ihn-int/SeniorProject/Software/uartboot/uartboot.c

// =============================================================================
//  Program : uartboot.c
//  Author  : Chun-Jen Tsai
//  Date    : Nov/12/2021
// -----------------------------------------------------------------------------
//  Description:
//  This is the boot code for Aquila SoC.  Upon reset, the boot code waiting
//  for an ELF program file to be transferred from the UART port.
//  The processor will be halted when the execution is finished.
// -----------------------------------------------------------------------------
//  Revision information:
//
//  Sep/17/2022, by Chun-Jen Tsai
//    Modify the ELF loader to perform on-the-fly loading from UART without
//    using any ELF file loading buffer.
//
//  Oct/15/2022, by Chun-Jen Tsai
//    Use different schemes for loading into TCM (on-the-fly) and into
//    DRAM (buffered loasding).
//
//  Jan/24/2025, by Jun-Kai Chen
//    Modify the pseudo instruction of addressing variable to fit the medany
//    memory model. Also modify the size of header buffers to fit the elf64
//    format.
// -----------------------------------------------------------------------------
//  License information:
//
//  This software is released under the BSD-3-Clause Licence,
//  see https://opensource.org/licenses/BSD-3-Clause for details.
//  In the following license statements, "software" refers to the
//  "source code" of the complete hardware/software system.
//
//  Copyright 2019,
//                    Embedded Intelligent Systems Lab (EISL)
//                    Deparment of Computer Science
//                    National Yang Ming Chiao Tung Uniersity (NYCU)
//                    Hsinchu, Taiwan.
//
//  All rights reserved.
//
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
//  3. Neither the name of the copyright holder nor the names of its contributors
//     may be used to endorse or promote products derived from this software
//     without specific prior written permission.
//
//  THIS SOFTWARE IS PROVIDED BY THE COPYRIGHT HOLDERS AND CONTRIBUTORS "AS IS"
//  AND ANY EXPRESS OR IMPLIED WARRANTIES, INCLUDING, BUT NOT LIMITED TO, THE
//  IMPLIED WARRANTIES OF MERCHANTABILITY AND FITNESS FOR A PARTICULAR PURPOSE
//  ARE DISCLAIMED. IN NO EVENT SHALL THE COPYRIGHT HOLDER OR CONTRIBUTORS BE
//  LIABLE FOR ANY DIRECT, INDIRECT, INCIDENTAL, SPECIAL, EXEMPLARY, OR
//  CONSEQUENTIAL DAMAGES (INCLUDING, BUT NOT LIMITED TO, PROCUREMENT OF
//  SUBSTITUTE GOODS OR SERVICES; LOSS OF USE, DATA, OR PROFITS; OR BUSINESS
//  INTERRUPTION) HOWEVER CAUSED AND ON ANY THEORY OF LIABILITY, WHETHER IN
//  CONTRACT, STRICT LIABILITY, OR TORT (INCLUDING NEGLIGENCE OR OTHERWISE)
//  ARISING IN ANY WAY OUT OF THE USE OF THIS SOFTWARE, EVEN IF ADVISED OF THE
//  POSSIBILITY OF SUCH DAMAGE.
// =============================================================================
#include <elf.h>
#include <stdint.h>
#include "io_uart.h"

int load_elf(Elf64_Ehdr *ehdr);
void dram_test();

// ------------------------------------------------------------------------------
//  Memory Map:
//     0x00000000 ~ 0x0000FFFF: on-chip memory (64KB, boot code)
//     0x80000000 ~ 0x8FFFFFFF: main memory (code, data, heap, and stack)
//     0xC0000000 ~ 0xCFFFFFFF: I/O device area
//     0xF0000000 ~ 0xFFFFFFFF: system device area
// ------------------------------------------------------------------------------

uint8_t *prog;
uint8_t eheader[64], pheader[56*4];
char    *organization = "EISL@NYCU, Hsinchu, Taiwan";
int     year = 2024;

int main(void)
{
    Elf64_Ehdr *ehdr = (Elf64_Ehdr *) eheader;
    uint32_t *magic = (uint32_t *) ELFMAG;
    uint32_t size;
    int idx;

    printf("=======================================================================\n");
    printf("Copyright (c) 2019-%d, %s.\n", year, organization);
    
    printf("The Aquila SoC is ready.\n");
    printf("Waiting for an ELF file to be sent from the UART ...\n");
    
    
    // Read the ELF header.
    for (idx = 0; idx < sizeof(Elf64_Ehdr); idx++)
    {
        eheader[idx] = inbyte();
    }

    // Read the Program headers.
    for (idx = 0; idx < ehdr->e_phentsize*ehdr->e_phnum; idx++)
    {
        pheader[idx] = inbyte();
    }
    if (*((uint32_t *) ehdr->e_ident) == *magic)
    {
        prog = (uint8_t *) ehdr->e_entry; // set program entry point
        size = ehdr->e_shoff + (ehdr->e_shentsize * ehdr->e_shnum);
        
        load_elf(ehdr);
        
        printf("\nProgram entry point at 0x%x, size = 0x%x.\n", prog, size);
        printf("-----------------------------------------------------------------------\n");
        
        // Call the entry point for execution.
        asm volatile ("fence.i");
        asm volatile ("la t0, prog");
        asm volatile ("ld ra, 0(t0)");
        asm volatile ("jalr ra, ra, 0");
        
    }
    else
    {
        printf("\n\nMagic number = 0x%X\n", *((uint32_t *) ehdr->e_ident));
        printf("\nThe magic number should be 0x%X\n", *magic);
        printf("Error! Not an ELF file.\n\n");
    }
    // Halt the processor.
    
    exit(0);
    
    return 0;
}

int load_elf(Elf64_Ehdr *ehdr)
{
    Elf64_Phdr *section;
    uint32_t skip, current_byte;
    uint32_t *mem;
    uint8_t  *dst_addr;
    int idx, jdx;

    current_byte = sizeof(Elf64_Ehdr) + ehdr->e_phentsize*ehdr->e_phnum;

    // Load all loadable sections of an ELF image to the destination.
    section = (Elf64_Phdr *) pheader;
    for (idx = 0; idx < ehdr->e_phnum; idx++)
    {    
        if (section[idx].p_type == PT_LOAD && section[idx].p_filesz != 0)
        {
            
            
            dst_addr = (uint8_t *) section[idx].p_paddr;
            skip = section[idx].p_offset - current_byte;
            while (skip-- > 0) inbyte(), current_byte++;

            for (jdx = 0; jdx < section[idx].p_filesz; jdx++)
            {
                dst_addr[jdx] = inbyte();
                current_byte++;
            }
            mem = (uint32_t *) &(dst_addr[jdx]);
            while (jdx < section[idx].p_memsz)
            {
                mem[(jdx>>2)] = 0;
                jdx += sizeof(int);
            }
            
        }
        
    }
    return 0;
}
