ihn-int/SeniorProject/Hardware/dram_version/src/core_rtl/dcache.v

`timescale 1ns / 1ps
// =============================================================================
//  Program : dcache.v
//  Author  : Jin-you Wu
//  Date    : Nov/01/2018
// -----------------------------------------------------------------------------
//  Description:
//  This module implements the L1 Data Cache with the following
//  properties:
//      4-way set associative
//      FIFO replacement policy
//      Write-back
//      Write allocate
// -----------------------------------------------------------------------------
//  Revision information:
//
//  Mar/03/2020, by Chih-Yu Hsiang:
//    Added AMO support.
//
//  Sep/24/2023, by Chun-Jen Tsai:
//    Modify the code to use distributed RAM to store VALID and DIRTY bits.
//    This modification significantly reduces the resource usage.
//
//  Jun/17/2025, by Jun-Kai Chen:
//    Modify data rearrangement to fit 64-bit bus.
// -----------------------------------------------------------------------------
//  License information:
//
//  This software is released under the BSD-3-Clause Licence,
//  see https://opensource.org/licenses/BSD-3-Clause for details.
//  In the following license statements, "software" refers to the
//  "source code" of the complete hardware/software system.
//
//  Copyright 2019,
//                    Embedded Intelligent Systems Lab (EISL)
//                    Deparment of Computer Science
//                    National Chiao Tung Uniersity
//                    Hsinchu, Taiwan.
//
//  All rights reserved.
//
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
//  3. Neither the name of the copyright holder nor the names of its contributors
//     may be used to endorse or promote products derived from this software
//     without specific prior written permission.
//
//  THIS SOFTWARE IS PROVIDED BY THE COPYRIGHT HOLDERS AND CONTRIBUTORS "AS IS"
//  AND ANY EXPRESS OR IMPLIED WARRANTIES, INCLUDING, BUT NOT LIMITED TO, THE
//  IMPLIED WARRANTIES OF MERCHANTABILITY AND FITNESS FOR A PARTICULAR PURPOSE
//  ARE DISCLAIMED. IN NO EVENT SHALL THE COPYRIGHT HOLDER OR CONTRIBUTORS BE
//  LIABLE FOR ANY DIRECT, INDIRECT, INCIDENTAL, SPECIAL, EXEMPLARY, OR
//  CONSEQUENTIAL DAMAGES (INCLUDING, BUT NOT LIMITED TO, PROCUREMENT OF
//  SUBSTITUTE GOODS OR SERVICES; LOSS OF USE, DATA, OR PROFITS; OR BUSINESS
//  INTERRUPTION) HOWEVER CAUSED AND ON ANY THEORY OF LIABILITY, WHETHER IN
//  CONTRACT, STRICT LIABILITY, OR TORT (INCLUDING NEGLIGENCE OR OTHERWISE)
//  ARISING IN ANY WAY OUT OF THE USE OF THIS SOFTWARE, EVEN IF ADVISED OF THE
//  POSSIBILITY OF SUCH DAMAGE.
// =============================================================================
`include "aquila_config.vh"

module dcache
#(parameter XLEN = 64,
  parameter CACHE_SIZE = 4, // KB
  parameter CLSIZE = `CLP    // Cache line size.
)
(
    /////////// System signals   ///////////////////////////////////////////////
    input                     clk_i, rst_i,

    /////////// Processor signals //////////////////////////////////////////////
    input                     p_strobe_i,      // Processor request signal.
    input                     p_rw_i,          // 0 for read, 1 for write.
    input  [XLEN/8-1 : 0]     p_byte_enable_i, // Byte-enable signal.
    input  [XLEN-1 : 0]       p_addr_i,        // Memory addr of the request.
    input  [XLEN-1 : 0]       p_data_i,        // Data to main memory.
    output reg [XLEN-1 : 0]   p_data_o,        // Data from main memory.
    output                    p_ready_o,       // The cache data is ready.
    input                     p_flush_i,       // Cache flush request.

    /////////// External memory signals   //////////////////////////////////////
    output reg                m_strobe_o,      // Cache request to memory.
    output reg [XLEN-1 : 0]   m_addr_o,        // Address of the request.
    output reg                m_rw_o,          // 0 for read, 1 for write.
    input  [CLSIZE-1 : 0]     m_data_i,        // Data from memory controller.
    output reg [CLSIZE-1 : 0] m_data_o,        // Cache data to memory controller.
    input                     m_ready_i,       // Data from memory is ready.

    /////////// Control signals to other caches   //////////////////////////////
    output reg                busy_flushing_o, // D-Cache is busy flushing

    /////////// AMO signals      ///////////////////////////////////////////////
    input                     p_is_amo_i,      // AMO request from core.
    input  [4 : 0]            p_amo_type_i,    // Type of AMO from core.
    input                     p_amo_word_sel_i,// Word select from core. New signal
    output                    m_is_amo_o,      // AMO request to D-memory.
    output reg [4 : 0]        m_amo_type_o,    // Type of AMO to D-memory.
    output reg                m_amo_word_sel_o // Word select from core. New signal
);

//=======================================================
// Cache parameters
//=======================================================
localparam N_WAYS      = 4;
localparam N_LINES     = (CACHE_SIZE*1024*8) / (N_WAYS*CLSIZE); // 64

localparam WAY_BITS    = $clog2(N_WAYS);
localparam BYTE_BITS   = $clog2(XLEN/8); // A dword is 8 bytes
localparam WORD_BITS   = $clog2(CLSIZE/XLEN); // A dword is 64 bits
localparam LINE_BITS   = $clog2(N_LINES);
localparam NONTAG_BITS = LINE_BITS + WORD_BITS + BYTE_BITS;
localparam TAG_BITS    = XLEN - NONTAG_BITS;

//=======================================================
// N-way associative cache signals
//=======================================================
wire                   way_hit[0 : N_WAYS-1];     // Cache-way hit flag.
reg  [WAY_BITS-1 : 0]  hit_index;                 // Decoded way_hit[] signal.
wire                   cache_hit;                 // Got a cache hit?
reg  [CLSIZE-1 : 0]    c_data_i;                  // Data to write into cache.
reg  [CLSIZE-1 : 0]    c_data_update;             // Updated cache data.
reg  [CLSIZE-1 : 0]    m_data_update;             // Updated memory data.
wire [CLSIZE-1 : 0]    c_block[0 : N_WAYS-1];     // Cache blocks from N cache way.
wire [CLSIZE-1 : 0]    c_data_hit;                // Data from the hit cache block.
reg                    cache_write[0 : N_WAYS-1]; // WE signal for a $ tag & block.
reg                    valid_write[0 : N_WAYS-1]; // WE signal for a $ valid bit.
reg                    dirty_write[0 : N_WAYS-1]; // WE signal for a $ dirty bit.
wire [TAG_BITS-1 : 0]  c_tag_o[0 : N_WAYS-1];     // Tag bits of current $ blocks.
wire                   c_valid_o[0 : N_WAYS-1];   // Validity of current $ blocks.
wire                   c_dirty_o[0 : N_WAYS-1];   // Dirtiness of current $ blocks.
reg  [LINE_BITS-1 : 0] init_count;                // Counter to initialize valid bits.

integer idx;

assign c_data_hit = c_block[hit_index];

//=======================================================
// FIFO replacement policy signals
//=======================================================
reg  [WAY_BITS-1 : 0] FIFO_cnt[0 : N_LINES-1];   // Replace policy counter.
reg  [WAY_BITS-1 : 0] victim_sel;                // The victim cache select.

//=======================================================
// Cache line and tag calculations
//=======================================================
wire [WORD_BITS-1 : 0] line_offset;
wire [LINE_BITS-1 : 0] line_index;
wire [TAG_BITS-1  : 0] tag;
wire [LINE_BITS-1 : 0] addr_sram;
reg  [XLEN-1 : 0]      p_addr_r;

assign line_offset = (p_strobe_i)? p_addr_i[WORD_BITS + BYTE_BITS - 1 : BYTE_BITS] :
                                   p_addr_r[WORD_BITS + BYTE_BITS - 1 : BYTE_BITS];
assign line_index  = (p_strobe_i)? p_addr_i[NONTAG_BITS - 1 : WORD_BITS + BYTE_BITS] :
                                   p_addr_r[NONTAG_BITS - 1 : WORD_BITS + BYTE_BITS];
assign tag         = p_addr_r[XLEN - 1 : NONTAG_BITS];

//=======================================================
// Processor and memory interface signals
//=======================================================

// Input signal from processor   //////////////////////////////////////////
reg [XLEN-1 : 0] datain_from_p;
reg              rw;                 // 0 is for read, 1 is for write
reg [XLEN/8-1:0] byte_enable_from_p; // Which bytes are written if (rw == 1)
reg              is_amo_reg;

// Output signal to processor
reg              p_ready_reg;

// Input data from memory /////////////////////////////////////////////////
reg [CLSIZE-1 : 0] m_data;

//=======================================================
// Control signals for flushing all cache blocks
//=======================================================
reg [LINE_BITS-1 : 0] N_LINES_cnt;
reg [WAY_BITS-1 : 0]  N_WAYS_cnt;
wire NeedtoWb = c_dirty_o[N_WAYS_cnt];
wire WbAllFinish = (N_LINES_cnt == N_LINES - 1 && N_WAYS_cnt == N_WAYS - 1);
reg WbAllFinish_r;

//=======================================================
// Cache Finite State Machine
//=======================================================
localparam Init             = 0,
           Idle             = 1,
           Analysis         = 2,
           WbtoMem          = 3,
           WbtoMemFinish    = 4,
           RdfromMem        = 5,
           RdfromMemFinish  = 6,
           WbtoMemAll       = 7,
           WbtoMemAllFinish = 8,
           RdAmo            = 9,
           RdAmoFinish      = 10;

// Cache controller state registers
reg [ 3 : 0] S, S_nxt;

//====================================================
// Cache Controller FSM
//====================================================
always @(posedge clk_i)
begin
    if (rst_i)
        S <= Init;
    else
        S <= S_nxt;
end

always @(*)
begin
    case (S)
        Init: // Multi-cycle initialization of the VALID bits memory.
            if (init_count < N_LINES - 1)
                S_nxt = Init;
            else
                S_nxt = Idle;
        Idle:
            if (p_strobe_i || p_flush_i)
                S_nxt = Analysis;
            else
                S_nxt = Idle;
        Analysis:
            if (busy_flushing_o)
                S_nxt = WbtoMemAll;
            else if (p_is_amo_i)
                S_nxt = (cache_hit & c_dirty_o[hit_index])? WbtoMem : RdAmo;
            else if (!cache_hit)
                S_nxt = (c_dirty_o[victim_sel])? WbtoMem : RdfromMem;
            else // cache hit and not amo
                S_nxt = Idle;
        WbtoMem:
            if (m_ready_i)
                S_nxt = WbtoMemFinish;
            else
                S_nxt = WbtoMem;
        WbtoMemFinish:
            S_nxt = (p_is_amo_i)? RdAmo : RdfromMem;
        RdfromMem:
            if (m_ready_i)
                S_nxt = RdfromMemFinish;
            else
                S_nxt = RdfromMem;
        RdfromMemFinish:
            S_nxt = Idle;
        WbtoMemAll:
            if (NeedtoWb)
                if (m_ready_i)
                    S_nxt = WbtoMemAllFinish;
                else
                    S_nxt = WbtoMemAll;
            else
                S_nxt = WbtoMemAllFinish;
        WbtoMemAllFinish:
            S_nxt = (WbAllFinish_r)? Idle : WbtoMemAll;
        RdAmo:
            if (m_ready_i)
                S_nxt = RdAmoFinish;
            else
                S_nxt = RdAmo;
        RdAmoFinish:
            S_nxt = Idle;
        default:
            S_nxt = Idle;
    endcase
end

// Initialization of the valid bits to zeros upon reset.
always @ (posedge clk_i)
begin
    if (S == Init)
        init_count <= init_count + 1;
    else
        init_count <= {LINE_BITS{1'b0}};
end

// Check and see if any cache way has the matched memory block.
assign way_hit[0] = (c_valid_o[0] && (c_tag_o[0] == tag))? 1 : 0;
assign way_hit[1] = (c_valid_o[1] && (c_tag_o[1] == tag))? 1 : 0;
assign way_hit[2] = (c_valid_o[2] && (c_tag_o[2] == tag))? 1 : 0;
assign way_hit[3] = (c_valid_o[3] && (c_tag_o[3] == tag))? 1 : 0;
assign cache_hit  = (way_hit[0] || way_hit[1] || way_hit[2] || way_hit[3]);

always @(*)
begin
    case ( { way_hit[0], way_hit[1], way_hit[2], way_hit[3] } )
        4'b1000: hit_index = 0;
        4'b0100: hit_index = 1;
        4'b0010: hit_index = 2;
        4'b0001: hit_index = 3;
        default: hit_index = 0; // error: multiple-way hit!
    endcase
end

always @(posedge clk_i)
begin
    victim_sel <= FIFO_cnt[line_index];
end

always @(posedge clk_i)
begin
    if (rst_i)
        for (idx = 0; idx < N_LINES; idx = idx + 1) FIFO_cnt[idx] <= 0;
    else if (S == RdfromMemFinish)
        FIFO_cnt[line_index] <= FIFO_cnt[line_index] + 1;
end

//====================================================
// Register some signals from the processor/memory.
//====================================================

// Register the address from the processor.
always@(posedge clk_i) begin
    if (rst_i) begin
        p_addr_r <= {XLEN{1'b0}};
    end else if (p_strobe_i) begin
        p_addr_r <= p_addr_i;
    end
end

// Register the data, rw, and byte enable signals from the processor.
always @(posedge clk_i)
begin
    if (S == Idle)
    begin
        datain_from_p <= p_data_i;
        rw <= p_rw_i;
        byte_enable_from_p <= p_byte_enable_i;
    end
    else
    begin
        datain_from_p <= datain_from_p;
        rw <= rw;
        byte_enable_from_p <= byte_enable_from_p;
    end
end

// Register the input data from the main memory.
always @(posedge clk_i)
begin
    if (S == RdfromMem || S == RdAmo)
        m_data <= m_data_i;
    else
        m_data <= m_data;
end

//=======================================================
// Write back all cache blocks to the main memory
//=======================================================
assign addr_sram   = (busy_flushing_o)? N_LINES_cnt : line_index;

always @(posedge clk_i)
begin
    if (rst_i || S == Idle)
        N_LINES_cnt <= {LINE_BITS{1'b0}};
    else if (S_nxt == WbtoMemAllFinish)
        N_LINES_cnt <= N_LINES_cnt + 1;
end

always @(posedge clk_i)
begin
    if (rst_i || S == Idle)
        N_WAYS_cnt <= {WAY_BITS{1'b0}};
    else if (N_LINES_cnt == N_LINES - 1 && S_nxt == WbtoMemAllFinish)
        N_WAYS_cnt <= N_WAYS_cnt + 1;
end

always @(posedge clk_i) begin
    WbAllFinish_r <= WbAllFinish;
end

//-----------------------------------------------
// Read a 32-bit word from the target cache line
//-----------------------------------------------
reg [XLEN-1 : 0] fromCache; // Get the specific word in cache line
reg [XLEN-1 : 0] fromMem;   // Get the specific word in memory line

always @(*)
begin // for hit
    case (line_offset)
`ifdef ARTY
        1'b0: fromCache = c_data_hit[127: 64];
        1'b1: fromCache = c_data_hit[ 63:  0];
`else // KC705, hasn't finished yet.
        3'b111: fromCache = c_data_hit[ 31: 0];    // [255:224]
        3'b110: fromCache = c_data_hit[ 63: 32];   // [223:192]
        3'b101: fromCache = c_data_hit[ 95: 64];   // [191:160]
        3'b100: fromCache = c_data_hit[127: 96];   // [159:128]
        3'b011: fromCache = c_data_hit[159: 128];  // [127: 96]
        3'b010: fromCache = c_data_hit[191: 160];  // [ 95: 64]
        3'b001: fromCache = c_data_hit[223: 192];  // [ 63: 32]
        3'b000: fromCache = c_data_hit[255: 224];  // [ 31:  0]
`endif
    endcase
end

always @(*)
begin // for miss
    case (line_offset)
`ifdef ARTY
        1'b0: fromMem = m_data[127: 64];
        1'b1: fromMem = m_data[ 63:  0];
`else // KC705, hasn't finished yet.
        3'b111: fromMem = m_data[ 31: 0];       // [255:224]
        3'b110: fromMem = m_data[ 63: 32];      // [223:192]
        3'b101: fromMem = m_data[ 95: 64];      // [191:160]
        3'b100: fromMem = m_data[127: 96];      // [159:128]
        3'b011: fromMem = m_data[159: 128];     // [127: 96]
        3'b010: fromMem = m_data[191: 160];     // [ 95: 64]
        3'b001: fromMem = m_data[223: 192];     // [ 63: 32]
        3'b000: fromMem = m_data[255: 224];     // [ 31:  0]
`endif
    endcase
end

//======================================================================
// Generate Output signals.
//======================================================================

always @(*)
begin // Note: p_data_o is significant when processor read data
    if (S == RdAmoFinish)
        p_data_o = m_data[CLSIZE-1:CLSIZE-XLEN];
    else if ((S == Analysis) && cache_hit && !rw)
        p_data_o = fromCache;
    else if ((S == RdfromMemFinish) && !rw)
        p_data_o = fromMem;
    else
        p_data_o = {XLEN{1'b0}};
end

always @(*)
begin
    if (((S == Analysis) && cache_hit && ~p_is_amo_i && !p_flush_i) ||
        (S == RdfromMemFinish) ||
        (S == RdAmoFinish) ||
        (S == WbtoMemAllFinish && WbAllFinish_r))
        p_ready_reg = 1;
    else
        p_ready_reg = 0;
end

assign p_ready_o = p_ready_reg;

//======================================================================
// Create a single-cycle memory request pluse for the memory controller
//======================================================================
// The old code uses the reqest/act protocol, which is corrected by the
// CDC synchronizer to match the strobe protocol of MIG. Modified to
// strobe protocol by Chun-Jen Tsai, 09/29/2023.
wire m_strobe;
reg  m_strobe_r;

assign m_strobe = (S == RdfromMem || S == WbtoMem || S == RdAmo ||
                  (S == WbtoMemAll && NeedtoWb)) && !m_ready_i;

always @(posedge clk_i)
    m_strobe_r <= m_strobe;

always @(posedge clk_i)
begin
    if (rst_i)
        m_strobe_o <= 0;
    else if (m_strobe && !m_strobe_r)
        m_strobe_o <= 1;
    else
        m_strobe_o <= 0;
end
//======================================================================

// Modified: Use the byte bits to present the address.
always @(posedge clk_i)
begin
    if (rst_i)
        m_addr_o <= 0;
    else if (S == WbtoMemAll)
        m_addr_o <= {c_tag_o[N_WAYS_cnt], N_LINES_cnt, {WORD_BITS{1'b0}}, {BYTE_BITS{1'b0}}};
    else if (S == WbtoMem) // the dirty data addr
        m_addr_o <= (is_amo_reg)?
                        {c_tag_o[hit_index], line_index, {WORD_BITS{1'b0}}, {BYTE_BITS{1'b0}}} :
                        {c_tag_o[victim_sel], line_index, {WORD_BITS{1'b0}}, {BYTE_BITS{1'b0}}};
    else if (S == RdfromMem) // read a cache block
        m_addr_o <= {p_addr_i[XLEN-1 : WORD_BITS+BYTE_BITS], {WORD_BITS{1'b0}}, {BYTE_BITS{1'b0}}};
    else if (S == RdAmo)
        m_addr_o <= p_addr_i;
    else
        m_addr_o <= {XLEN{1'b0}};
end

always @(posedge clk_i)
begin
    if (rst_i)
        m_data_o <= 0;
    else if (S == WbtoMemAll && NeedtoWb)
        m_data_o <= c_block[N_WAYS_cnt];
    else if (S == WbtoMem) // the dirty data write back to memory
        m_data_o <= (is_amo_reg)? c_data_hit : c_block[victim_sel];
    else if (S == RdAmo)
        m_data_o <= {p_data_i, {CLSIZE-XLEN{1'b0}}};
    else
        m_data_o <= 0;
end

//------------------------------------------------------------------------
// Write the correct bytes according to the signal byte_enable_from_p
//------------------------------------------------------------------------
reg [XLEN-1 : 0] update_data;

always @(*)
begin           // write miss : write hit;
    case (byte_enable_from_p)
        // DataMem_Addr[2:0] == 3'b000
        8'b0000_0001: // store byte
            update_data = (S == RdfromMemFinish) ?
                {   fromMem[63:8], datain_from_p[7:0] } :
                { fromCache[63:8], datain_from_p[7:0] };
        8'b0000_0011: // store half
            update_data = (S == RdfromMemFinish) ?
                {   fromMem[63:16], datain_from_p[15:0] } :
                { fromCache[63:16], datain_from_p[15:0] };
        8'b0000_1111: // store word
            update_data = (S == RdfromMemFinish) ?
                {   fromMem[63:32], datain_from_p[31:0] } :
                { fromCache[63:32], datain_from_p[31:0] };
        8'b1111_1111: // store dword
            update_data = datain_from_p;
        // DataMem_Addr[2:0] == 3'b001
        8'b0000_0010: // store byte
            update_data = (S == RdfromMemFinish) ?
                {   fromMem[63:16], datain_from_p[15:8],   fromMem[7:0] } :
                { fromCache[63:16], datain_from_p[15:8], fromCache[7:0] };
        // DataMemAddr[2:0] == 3'b010
        8'b0000_0100: // store byte
            update_data = (S == RdfromMemFinish) ?
                {   fromMem[63:24], datain_from_p[23:16],   fromMem[15:0] } :
                { fromCache[63:24], datain_from_p[23:16], fromCache[15:0] };
        8'b0000_1100: // store half
            update_data = (S == RdfromMemFinish) ?
                {   fromMem[63:32], datain_from_p[31:16],   fromMem[15:0] } :
                { fromCache[63:32], datain_from_p[31:16], fromCache[15:0] };
        // DataMem_Addr[2:0] == 3'b011
        8'b0000_1000: // store byte
            update_data = (S == RdfromMemFinish) ?
                {   fromMem[63:32], datain_from_p[31:24],   fromMem[23:0] } :
                { fromCache[63:32], datain_from_p[31:24], fromCache[23:0] };
        // DataMem_Addr[2:0] == 3'b100
        8'b0001_0000: // store byte
            update_data = (S == RdfromMemFinish) ?
                {   fromMem[63:40], datain_from_p[39:32],   fromMem[31:0] } :
                { fromCache[63:40], datain_from_p[39:32], fromCache[31:0] };
        8'b0011_0000: // store half
            update_data = (S == RdfromMemFinish) ?
                {   fromMem[63:48], datain_from_p[47:32],   fromMem[31:0] } :
                { fromCache[63:48], datain_from_p[47:32], fromCache[31:0] };
        8'b1111_0000: // store word
            update_data = (S == RdfromMemFinish) ?
                { datain_from_p[63:32],   fromMem[31:0] } :
                { datain_from_p[63:32], fromCache[31:0] };
        // DataMem_Addr[2:0] == 3'b101
        8'b0010_0000: // store byte
            update_data = (S == RdfromMemFinish) ?
                {   fromMem[63:48], datain_from_p[47:40],   fromMem[39:0] } :
                { fromCache[63:48], datain_from_p[47:40], fromCache[39:0] };
        // DataMem_Addr[2:0] == 3'b110
        8'b0100_0000: // store byte
            update_data = (S == RdfromMemFinish) ?
                {   fromMem[63:56], datain_from_p[55:48],   fromMem[47:0] } :
                { fromCache[63:56], datain_from_p[55:48], fromCache[47:0] };
        8'b1100_0000: // store half
            update_data = (S == RdfromMemFinish) ?
                { datain_from_p[63:48],   fromMem[47:0] } :
                { datain_from_p[63:48], fromCache[47:0] };
        // DataMem_Addr[2:0] == 3'b111
        8'b1000_0000: // store byte
            update_data = (S == RdfromMemFinish) ?
                { datain_from_p[63:56],   fromMem[55:0] } :
                { datain_from_p[63:56], fromCache[55:0] };
        default: update_data = 64'b0;
    endcase
end

//------------------------------------------------------------------------
// Write a 64-bit dword into the target cache line.
//------------------------------------------------------------------------
/* Writing into cache from the processor or the main memory */
always @(*) begin
    case (line_offset)
`ifdef ARTY
        1'b0: c_data_update = {update_data, c_data_hit[63: 0]};
        1'b1: c_data_update = {c_data_hit[127: 64], update_data};
`else // KC705, hasn't finished yet.
        3'b111: c_data_update = {c_data_hit[255: 32], update_data};
        3'b110: c_data_update = {c_data_hit[255: 64], update_data, c_data_hit[ 31:0]};
        3'b101: c_data_update = {c_data_hit[255: 96], update_data, c_data_hit[ 63:0]};
        3'b100: c_data_update = {c_data_hit[255:128], update_data, c_data_hit[ 95:0]};
        3'b011: c_data_update = {c_data_hit[255:160], update_data, c_data_hit[127:0]};
        3'b010: c_data_update = {c_data_hit[255:192], update_data, c_data_hit[159:0]};
        3'b001: c_data_update = {c_data_hit[255:224], update_data, c_data_hit[191:0]};
        3'b000: c_data_update = {update_data, c_data_hit[223:0]};
`endif
    endcase
end

always @(*) begin
    case (line_offset)
`ifdef ARTY
        1'b0: m_data_update = {update_data, m_data[63: 0]};
        1'b1: m_data_update = {m_data[127: 64], update_data};
`else // KC705, hasn't finished yet.
        3'b111: m_data_update = {m_data[255: 32], update_data};
        3'b110: m_data_update = {m_data[255: 64], update_data, m_data[ 31:0]};
        3'b101: m_data_update = {m_data[255: 96], update_data, m_data[ 63:0]};
        3'b100: m_data_update = {m_data[255:128], update_data, m_data[ 95:0]};
        3'b011: m_data_update = {m_data[255:160], update_data, m_data[127:0]};
        3'b010: m_data_update = {m_data[255:192], update_data, m_data[159:0]};
        3'b001: m_data_update = {m_data[255:224], update_data, m_data[191:0]};
        3'b000: m_data_update = {update_data, m_data[223:0]};
`endif
    endcase
end

always @(*)
begin
    if (!rw) // Processor read miss and update cache data
        c_data_i = (S == RdfromMemFinish) ? m_data : {CLSIZE{1'b0}};
    else begin   // Processor write cache
        if ( (S == Analysis) && cache_hit ) // write hit
            c_data_i = c_data_update;
        else if (S == RdfromMemFinish)      // write miss
            c_data_i = m_data_update;
        else
            c_data_i = {CLSIZE{1'b0}};
    end
end

always @(posedge clk_i)
begin
    if (rst_i)
        m_rw_o <= 0;
    else if (S == WbtoMem || S == WbtoMemAll || S == RdAmo)
        m_rw_o <= 1;
    else
        m_rw_o <= 0; // default: Read memory
end

// AMO output signal
always @(posedge clk_i ) begin
    if (rst_i)
        is_amo_reg <= 1'b0;
    else if ( S == Analysis )
        is_amo_reg <= p_is_amo_i;
end

assign m_is_amo_o = (S == RdAmo) ? is_amo_reg : 1'b0 ;

always @(posedge clk_i ) begin
    // data signal don't reset
    if ( S == Analysis ) begin
        m_amo_type_o <= p_amo_type_i;
        m_amo_word_sel_o <= p_amo_word_sel_i;
    end    
end

// Set a signal for flushing-in-progress notification
always @(posedge clk_i) begin
    if (rst_i)
        busy_flushing_o <= 0;
    else if (S == Idle && !busy_flushing_o)
        busy_flushing_o <= p_flush_i;
    else if (WbAllFinish_r && S_nxt == WbtoMemAllFinish)
        busy_flushing_o <= 0;
end

//=======================================================================
//  Compute the write flags for cache block & tag, valid, and dirty bits
//=======================================================================
always @(*)
begin
    if ((S == Analysis) && cache_hit && rw)
        for (idx = 0; idx < N_WAYS; idx = idx + 1)
            cache_write[idx] = way_hit[idx];
    else if (S == RdfromMemFinish)
        for (idx = 0; idx < N_WAYS; idx = idx + 1)
            cache_write[idx] = (idx == victim_sel);
    else
        for (idx = 0; idx < N_WAYS; idx = idx + 1)
            cache_write[idx] = 1'b0;
end

always @(*)
begin
    if (S == Init)
        for (idx = 0; idx < N_WAYS; idx = idx + 1)
            valid_write[idx] = 1'b1;
    else if (S == RdfromMem && m_ready_i)
        for (idx = 0; idx < N_WAYS; idx = idx + 1)
            valid_write[idx] = (idx == victim_sel);
    else if (S == RdAmo && m_ready_i && cache_hit)
        for (idx = 0; idx < N_WAYS; idx = idx + 1)
            valid_write[idx] = (idx == hit_index);
    else
        for (idx = 0; idx < N_WAYS; idx = idx + 1)
            valid_write[idx] = 1'b0;
end

always @(*)
begin
    if (S == Init)
        for (idx = 0; idx < N_WAYS; idx = idx + 1)
            dirty_write[idx] = 1'b1;
    else if (S_nxt == WbtoMemAllFinish)
        for (idx = 0; idx < N_WAYS; idx = idx + 1)
            dirty_write[idx] = (idx == N_WAYS_cnt);
    else if (S == RdfromMem && m_ready_i && rw)
        for (idx = 0; idx < N_WAYS; idx = idx + 1)
            dirty_write[idx] = (idx == victim_sel);
    else if ((S == Analysis && cache_hit && rw) ||
             (S == RdAmo && m_ready_i && cache_hit))
        for (idx = 0; idx < N_WAYS; idx = idx + 1)
            dirty_write[idx] = (idx == hit_index);
    else
        for (idx = 0; idx < N_WAYS; idx = idx + 1)
            dirty_write[idx] = 1'b0;
end

//=======================================================
//  Cache data storage in Block RAM
//=======================================================
genvar i;
generate
    for (i = 0; i < N_WAYS; i = i + 1)
    begin
        sram #(.DATA_WIDTH(CLSIZE), .N_ENTRIES(N_LINES))
             DATA_BRAM(
                 .clk_i(clk_i),
                 .en_i(1'b1),
                 .we_i(cache_write[i]),
                 .addr_i(addr_sram),
                 .data_i(c_data_i),  // data from processor or memory.
                 .data_o(c_block[i])
             );
    end
endgenerate

//=======================================================
//  Tags storage in Block RAM
//=======================================================
genvar j;
generate
    for (j = 0; j < N_WAYS; j = j + 1)
    begin
        sram #(.DATA_WIDTH(TAG_BITS), .N_ENTRIES(N_LINES))
             TAG_BRAM(
                 .clk_i(clk_i),
                 .en_i(1'b1),
                 .we_i(cache_write[j]),
                 .addr_i(addr_sram),
                 .data_i(tag),
                 .data_o(c_tag_o[j])
             );
    end
endgenerate

//=======================================================
//  Valid bits storage in distributed RAM
//=======================================================
genvar k;
generate
    for (k = 0; k < N_WAYS; k = k + 1)
    begin
        distri_ram #(.ENTRY_NUM(N_LINES), .XLEN(1))
             VALID_RAM(
                 .clk_i(clk_i),
                 .we_i(valid_write[k]),
                 .read_addr_i(line_index),
                 .write_addr_i((S == Init)? init_count : line_index),
                 .data_i(S == RdfromMem && m_ready_i),
                 .data_o(c_valid_o[k])
             );
    end
endgenerate

//=======================================================
//  Dirty bits storage in distributed RAM
//=======================================================
wire [LINE_BITS-1 : 0] dirty_raddr = (S == WbtoMemAll)? N_LINES_cnt : line_index;
wire [LINE_BITS-1 : 0] dirty_waddr = (S_nxt == WbtoMemAllFinish)? N_LINES_cnt :
                                     (S == Init)? init_count : line_index;
wire                   dirty_datai = (S == RdfromMem && m_ready_i && rw) ||
                                     (S == Analysis && cache_hit && rw);
genvar m;
generate
    for (m = 0; m < N_WAYS; m = m + 1)
    begin
        distri_ram #(.ENTRY_NUM(N_LINES), .XLEN(1))
             DIRTY_RAM(
                 .clk_i(clk_i),
                 .we_i(dirty_write[m]),
                 .read_addr_i(dirty_raddr),
                 .write_addr_i(dirty_waddr),
                 .data_i(dirty_datai),
                 .data_o(c_dirty_o[m])
             );
    end
endgenerate

endmodule
