ihn-int/SeniorProject/Hardware/dram_version/src/core_rtl/csr_file.v

`timescale 1ns / 1ps
// =============================================================================
//  Program : csr_file.v
//  Author  : Jin-you Wu
//  Date    : Dec/18/2018
// -----------------------------------------------------------------------------
//  Description:
//  This module implements the Control and Status Register File of the
//  Aquila core (A RISC-V core).
// -----------------------------------------------------------------------------
//  Revision information:
//
//  Dec/16/2019, by Chun-Jen Tsai:
//    Map the CSR addresses of CYCLES & CYCLESH to that of MCYCLES & MCYCLESH's
//    counters so that 'RDCYCLE' & 'RDCYCLEH' pseudo instructions can read the
//    counters.
//
//  Aug/22/2020, by Yen-Yu Lee:
//    Major modification to CSR to support exception handling properly.
//    The original Aquila processes interrupts at the Execute stage and does
//    not handle exceptions. Now, both interrupts and exceptions generated at
//    various pipeline stages will be passed to and handled at the Writeback
//    stage.
//
//  Aug/26/2025, by Jun-Kai Chen:
//    Modify MXLEN, SXLEN, UXLEN to 64-bit and modify behavior per new SPEC.
// -----------------------------------------------------------------------------
//  License information:
//
//  This software is released under the BSD-3-Clause Licence,
//  see https://opensource.org/licenses/BSD-3-Clause for details.
//  In the following license statements, "software" refers to the
//  "source code" of the complete hardware/software system.
//
//  Copyright 2019,
//                    Embedded Intelligent Systems Lab (EISL)
//                    Deparment of Computer Science
//                    National Chiao Tung Uniersity
//                    Hsinchu, Taiwan.
//
//  All rights reserved.
//
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
//  3. Neither the name of the copyright holder nor the names of its contributors
//     may be used to endorse or promote products derived from this software
//     without specific prior written permission.
//
//  THIS SOFTWARE IS PROVIDED BY THE COPYRIGHT HOLDERS AND CONTRIBUTORS "AS IS"
//  AND ANY EXPRESS OR IMPLIED WARRANTIES, INCLUDING, BUT NOT LIMITED TO, THE
//  IMPLIED WARRANTIES OF MERCHANTABILITY AND FITNESS FOR A PARTICULAR PURPOSE
//  ARE DISCLAIMED. IN NO EVENT SHALL THE COPYRIGHT HOLDER OR CONTRIBUTORS BE
//  LIABLE FOR ANY DIRECT, INDIRECT, INCIDENTAL, SPECIAL, EXEMPLARY, OR
//  CONSEQUENTIAL DAMAGES (INCLUDING, BUT NOT LIMITED TO, PROCUREMENT OF
//  SUBSTITUTE GOODS OR SERVICES; LOSS OF USE, DATA, OR PROFITS; OR BUSINESS
//  INTERRUPTION) HOWEVER CAUSED AND ON ANY THEORY OF LIABILITY, WHETHER IN
//  CONTRACT, STRICT LIABILITY, OR TORT (INCLUDING NEGLIGENCE OR OTHERWISE)
//  ARISING IN ANY WAY OUT OF THE USE OF THIS SOFTWARE, EVEN IF ADVISED OF THE
//  POSSIBILITY OF SUCH DAMAGE.
// =============================================================================
`include "aquila_config.vh"

module csr_file #(
    parameter HART_ID = 0,
    parameter XLEN = 64
)(
    // System signals
    input                  clk_i,
    input                  rst_i,

    // From Decode
    input  [11: 0]          csr_raddr_i,
    
    // To Forwarding
    output [XLEN-1 : 0]     csr_data_o,

    // From Writeback
    input                   csr_we_i,
    input  [11: 0]          csr_waddr_i,
    input  [XLEN-1 : 0]     csr_wdata_i,

    // Interrupt requests
    input                   ext_irq_i,
    input                   tmr_irq_i,
    input                   sft_irq_i,
    output                  irq_taken_o,
    output [XLEN-1 : 0]     pc_handler_o,
    input  [XLEN-1 : 0]     nxt_unwb_PC_i,

    // PC of the current instruction
    input  [XLEN-1 : 0]     pc_i,

    // System Jump Operation
    input                   sys_jump_i,
    input  [1 : 0]          sys_jump_csr_addr_i,
    output                  sys_jump_o,
    output [XLEN-1 : 0]     sys_jump_csr_data_o,

    // Current privilege level
    output [1 : 0]          privilege_level_o,

    // Exception requests
    input                   xcpt_valid_i,
    input  [3 : 0]          xcpt_cause_i,
    input  [XLEN-1 : 0]     xcpt_tval_i
);

//==============================================================================================
// Parameter and Integer
//==============================================================================================

// =============================================================================================
//  Machine-level CSRs (v1.10)
//          CSR Name        Address         R/W Attribute       Full Name
`define     CSR_MSTATUS     12'h300         // MRW              Machine Status Register
`define     CSR_MISA        12'h301         // MRW              Machine ISA Register
`define     CSR_MEDELEG     12'h302         // MRW              Machine Exception Delegation Register
`define     CSR_MIDELEG     12'h303         // MRW              Machine Interrupt Delegation Register
`define     CSR_MIE         12'h304         // MRW              Machine Interrupt Enable Register
`define     CSR_MTVEC       12'h305         // MRW              Machine Trap-Vector Base-Address Register
`define     CSR_MCOUNTEREN  12'h306         // MRW              Machine Counter Enable

`define     CSR_MSCRATCH    12'h340         // MRW              Machine Scratch Register
`define     CSR_MEPC        12'h341         // MRW              Machine Exception Program Counter
`define     CSR_MCAUSE      12'h342         // MRW              Machine Cause Register
`define     CSR_MTVAL       12'h343         // MRW              Machine Trap Value Register
`define     CSR_MIP         12'h344         // MRW              Machine Interrupt Pending Register

`define     CSR_MCYCLE      12'hB00         // MRW              of Cycle counter
`define     CSR_MINSTRET    12'hB02         // MRW              Instructions-retired counter

`define     CSR_MVENDORID   12'hF11         // MRO              Machine Vendor ID Register
`define     CSR_MARCHID     12'hF12         // MRO              Machine Architecture ID Register
`define     CSR_MIMPID      12'hF13         // MRO              Machine Implementation ID Register
`define     CSR_MHARTID     12'hF14         // MRO              Hart ID Register

// =============================================================================================
//  Supervisor-level CSRs (v1.11)
//          CSR Name        Address         R/W Attribute       Full Name
`define     CSR_SSTATUS     12'h100         // SRW              Supervisor status register
`define     CSR_SEDELEG     12'h102         // SRW              Supervisor Exception Delegation Register
`define     CSR_SIDELEG     12'h103         // SRW              Supervisor Interrupt Delegation Register
`define     CSR_SIE         12'h104         // SRW              Supervisor Interrupt Enable Register
`define     CSR_STVEC       12'h105         // SRW              Supervisor Trap-Vector Base-Address Register
`define     CSR_SCOUNTEREN  12'h106         // SRW              Supervisor Counter Enable

`define     CSR_SSCRATCH    12'h140         // SRW              Supervisor Scratch Register
`define     CSR_SEPC        12'h141         // SRW              Supervisor Exception Program Counter
`define     CSR_SCAUSE      12'h142         // SRW              Supervisor Cause Register
`define     CSR_STVAL       12'h143         // SRW              Supervisor Trap Value Register
`define     CSR_SIP         12'h144         // SRW              Supervisor Interrupt Pending Register

`define     CSR_SATP        12'h180         // SRW              Supervisor address translation and protection

// =============================================================================================
//  User-level CSRs (v1.11)
//          CSR Name        Address         R/W Attribute       Full Name
`define     CSR_CYCLE       12'hC00         // RO               Cycle counter for RDCYCLE instruction.
`define     CSR_TIME        12'hC01         // RO               Timer for RDTIME instruction.
`define     CSR_INSTRET     12'hC02         // RO               Instructions-retired counter for RDINSTRET instruction.

// Exception
// -------------------------------------------------
// | Exception Code |       Descript               |
// -------------------------------------------------
// |       0        |Instruction address misaligned|
// -------------------------------------------------
// |       1        |Instruction  access fault     |
// -------------------------------------------------
// |       2        |Illegal instruction           |
// -------------------------------------------------
// |       3        |Breakpoint                    |
// -------------------------------------------------
// |       4        |Load address misaligned       |
// -------------------------------------------------
// |       5        |Load access fault             |
// -------------------------------------------------
// |       6        |Store/AMO address misaligned  |
// -------------------------------------------------
// |       7        |Store/AMO access fault        |
// -------------------------------------------------
// |       8        |Environment call from U-mode  |
// -------------------------------------------------
// |       9        |Environment call from S-mode  |
// -------------------------------------------------
// |      10        |Reserved                      |
// -------------------------------------------------
// |      11        |Environment call from M-mode  |
// -------------------------------------------------
// |      12        |Instruction page fault        |
// -------------------------------------------------
// |      13        |Load page fault               |
// -------------------------------------------------
// |      14        |Reserved                      |
// -------------------------------------------------
// |      15        |Store/AMO page fault          |
// -------------------------------------------------

// Interrupt
// -------------------------------------------------
// | Exception Code |       Descript               |
// -------------------------------------------------
// |       0        |User software interrupt       |
// -------------------------------------------------
// |       1        |Supervisor software interrupt |
// -------------------------------------------------
// |       2        |Reserved                      |
// -------------------------------------------------
// |       3        |Machine software interrupt    |
// -------------------------------------------------
// |       4        |User timer interrupt          |
// -------------------------------------------------
// |       5        |Supervisor timer interrupt    |
// -------------------------------------------------
// |       6        |Reserved                      |
// -------------------------------------------------
// |       7        |Machine timer interrupt       |
// -------------------------------------------------
// |       8        |User external interrupt       |
// -------------------------------------------------
// |       9        |Supervisor external interrupt |
// -------------------------------------------------
// |      10        |Reserved                      |
// -------------------------------------------------
// |      11        |Machine external interrupt    |
// -------------------------------------------------
//==============================================================================================

`define M_MODE 2'b11
`define S_MODE 2'b01
`define U_MODE 2'b00

`define CSR_RW 2'b01
`define CSR_RS 2'b10
`define CSR_RC 2'b11

//M-Mode register
reg  [XLEN-1 : 0] mstatus_r;
reg  [XLEN-1 : 0] misa_r;
reg  [XLEN-1 : 0] mie_r;
reg  [XLEN-1 : 0] mip_r;
reg  [XLEN-1 : 0] mtvec_r;
reg  [XLEN-1 : 0] mscratch_r;
reg  [XLEN-1 : 0] mepc_r;
reg  [XLEN-1 : 0] mcause_r, mcause_d;
reg  [XLEN-1 : 0] mtval_r;  // for exception
reg  [XLEN-1 : 0] medeleg_r;  // for exception
reg  [XLEN-1 : 0] mideleg_r;  // for interrupt
reg  [XLEN-1 : 0] mcycle_r;
reg  [XLEN-1 : 0] minstret_r= 0;
wire [XLEN-1 : 0] mvendorid = 0;  // Non-commercial implementation, so return 0
wire [XLEN-1 : 0] marchid   = 0;
wire [XLEN-1 : 0] mimpid    = 0;
wire [XLEN-1 : 0] mhartid   = HART_ID;

//S-Mode register
wire [XLEN-1 : 0] sstatus;
wire [XLEN-1 : 0] sip;
wire [XLEN-1 : 0] sie;
reg  [XLEN-1 : 0] satp_r;
reg  [XLEN-1 : 0] stvec_r;
reg  [XLEN-1 : 0] sscratch_r;
reg  [XLEN-1 : 0] sepc_r;
reg  [XLEN-1 : 0] scause_r, scause_d;
reg  [XLEN-1 : 0] stval_r;  // for exception

//U-Mode register
reg  [XLEN-1 : 0] cycle_r;

reg  [1 : 0]      privilege_level_r;

wire [XLEN-1 : 0] mtvec_base;
wire [XLEN-1 : 0] stvec_base;

wire is_mret = (sys_jump_csr_addr_i == `M_MODE);
wire is_sret = (sys_jump_csr_addr_i == `S_MODE);
wire is_uret = (sys_jump_csr_addr_i == `U_MODE);    // not implemented

reg  [XLEN-1 : 0] csr_data;

// Interrupt
reg               trap_to_M;
reg  [3 : 0]      interrupt_cause;
reg               irq_taken;
reg  [XLEN-1 : 0] pc_handler;

//==============================================================================================
// User Logic                         
//==============================================================================================

// =============================================================================================
//  M-MODE SYSTEM Operations
//
//-----------------------------------------------
// mstatus
//-----------------------------------------------
// -------------------------------------
// | SD | WPRI | MBE | SBE | SXL | UXL |
// -------------------------------------
// | 63 |62  38| 37  | 36  |35 34|33 32|
// -------------------------------------
// ----------------------------------------------------------------------------------------------------------------------------------
// | WPRI | TSR | TW | TVM | MXR | SUM | MPRV |  XS  |  FS  | MPP | WPRI | SPP | MPIE | WPRI | SPIE | UPIE | MIE | WPRI | SIE | UIE |
// -----------------------------------------------------------------------------------------------------
// |30  23| 22  | 21 | 20  | 19  | 18  |  17  |16  15|14  13|12 11|10   9|  8  |  7   |  6   |  5   |  4   |  3  |  2   |  1  |  0  |
// ----------------------------------------------------------------------------------------------------------------------------------
//-----------------------------------------------
// sstatus
//-----------------------------------------------
// -------------------
// | SD | WPRI | UXL |
// -------------------
// | 63 |62  34|33 32|
// -------------------
// ------------------------------------------------------------------------------------------------
// |  WPRI  | MXR | SUM | WPRI |  XS  |  FS  | WPRI | SPP | WPRI | SPIE | UPIE | WPRI | SIE | UIE |
// ------------------------------------------------------------------------------------------------
// |30    20| 19  | 18  |  17  |16  15|14  13|12   9|  8  |7    6|  5   |  4   |3    2|  1  |  0  |
// ------------------------------------------------------------------------------------------------
// mstatus
always @(posedge clk_i)
begin
    if (rst_i)
        mstatus_r <= {28'b0, 2'b10, 2'b10, 19'b0, `M_MODE, 7'b0, 1'b1, 3'b0};
    else if (irq_taken)
        if (trap_to_M)  // MPIE <= MIE, MIE <= 0
            mstatus_r <= {mstatus_r[63:13], privilege_level_r, mstatus_r[10: 8],
                mstatus_r[3], mstatus_r[6:4], 1'b0, mstatus_r[2 : 0]};
        else // SPIE <= SIE, SIE <= 0
            mstatus_r <= {mstatus_r[63:9], privilege_level_r[0], mstatus_r[7:6],
                mstatus_r[1], mstatus_r[4:2], 1'b0, mstatus_r[0]};
    else if (sys_jump_i)
        if (is_mret)    // MIE <= MPIE, MPIE <= 1
            mstatus_r <= {mstatus_r[63: 8], 1'b1, mstatus_r[6 : 4], mstatus_r[7],
                mstatus_r[2 : 0]};
        else if (is_sret)   // SIE <= SPIE, SPIE <= 1
            mstatus_r <= {mstatus_r[63: 6], 1'b1, mstatus_r[4 : 2], mstatus_r[5],
                mstatus_r[0]};
    else if (csr_we_i)
        if (csr_waddr_i == `CSR_MSTATUS)
            mstatus_r <= csr_wdata_i;
        else if (csr_waddr_i == `CSR_SSTATUS)
            // write SD, MXR, SUM, XS, FS, SPP, SPIE, UPIE, SIE, UIE
            // Basically, all fields in sstatus except for XPRI
            mstatus_r <= {csr_wdata_i[63], mstatus_r[62:34], 2'b10, mstatus_r[30:20],
                csr_wdata_i[19:18], mstatus_r[17], csr_wdata_i[16:13], mstatus_r[12: 9],
                csr_wdata_i[8], mstatus_r[7 : 6], csr_wdata_i[5 : 4], mstatus_r[3 : 2],
                csr_wdata_i[1 : 0]};
end

//-----------------------------------------------
// mie
//-----------------------------------------------
// --------------------------------------------------------------------------------------------
// | WPRI | MEIE | WPRI | SEIE | UEIE | MTIE | WPRI | STIE | UTIE | MSIE | WPRI | SSIE | USIE |
// --------------------------------------------------------------------------------------------
// |63  12|  11  |  10  |  9   |  8   |  7   |  6   |  5   |  4   |  3   |  2   |  1   |  0   |
// --------------------------------------------------------------------------------------------
always @(posedge clk_i)
begin
    if (rst_i)
    begin
        mie_r <= 64'b0;
    end
    else if (csr_we_i && csr_waddr_i == `CSR_MIE)
    begin
        mie_r <= csr_wdata_i;
    end
end

//-----------------------------------------------
// mip
//-----------------------------------------------
// --------------------------------------------------------------------------------------------
// | WPRI | MEIP | WPRI | SEIP | UEIP | MTIP | WPRI | STIP | UTIP | MSIP | WPRI | SSIP | USIP |
// --------------------------------------------------------------------------------------------
// |63  12|  11  |  10  |  9   |  8   |  7   |  6   |  5   |  4   |  3   |  2   |  1   |  0   |
// --------------------------------------------------------------------------------------------
always @(posedge clk_i)
begin
    if (rst_i)
    begin
        mip_r <= 64'b0;
    end
    else if (csr_we_i && csr_waddr_i == `CSR_MIE)
    begin
        //only SEIP, UEIP, STIP, UTIP, SSIP, USIP writable
        mip_r <= {54'b0, csr_wdata_i[9:8], 2'b0, csr_wdata_i[5:4], 2'b0, csr_wdata_i[1:0]};
    end
    else
    begin
        //mip_MEIP <= ext_irq_i
        //mip_MTIP <= tmr_irq_i
        //mip_MSIP <= sft_irq_i
        mip_r <= {52'b0, ext_irq_i, 3'b0, tmr_irq_i, 3'b0, sft_irq_i, 3'b0} & mie_r;
    end
end

//-----------------------------------------------
// mtvec
//-----------------------------------------------
// ---------------
// | BASE | MODE |
// ---------------
// |64   2|1    0|
// ---------------
assign mtvec_base = {mtvec_r[XLEN-1 : 2], 2'b00};
always @(posedge clk_i)
begin
    if (rst_i)
    begin
        mtvec_r <= 64'h0; // the entry point of timer ISR
    end
    else if (csr_we_i && csr_waddr_i == `CSR_MTVEC)
    begin
        mtvec_r <= csr_wdata_i;
    end
end

//-----------------------------------------------
// mscratch
//-----------------------------------------------
always @(posedge clk_i)
begin
    if (rst_i)
    begin
        mscratch_r <= 64'b0;
    end
    else if (csr_we_i && csr_waddr_i == `CSR_MSCRATCH)
    begin
        mscratch_r <= csr_wdata_i;
    end
end

//-----------------------------------------------
// mepc
//-----------------------------------------------
always @(posedge clk_i)
begin
    if (rst_i)
    begin
        mepc_r <= 64'b0;
    end
    else if (irq_taken && trap_to_M)
    begin
        mepc_r <= nxt_unwb_PC_i;
    end
    else if (csr_we_i && csr_waddr_i == `CSR_MEPC)
    begin
        mepc_r <= csr_wdata_i;
    end
end

//-----------------------------------------------
// mcause
//-----------------------------------------------
// ------------------------------------
// | Interrupt | Excption Code (WLRL) |
// ------------------------------------
// |    63     |62                   0|
// ------------------------------------
always @(posedge clk_i)
begin
    if (rst_i)
    begin
        mcause_r <= 64'b0;
    end
    else if (irq_taken)
    begin
        mcause_r <= mcause_d;
    end
    else if (csr_we_i && csr_waddr_i == `CSR_MCAUSE)
    begin
        mcause_r <= csr_wdata_i;
    end
end

always @(*)
begin
    mcause_d = mcause_r;
    if (irq_taken && trap_to_M)
    begin
        if (!xcpt_valid_i) mcause_d = {1'b1, 59'b0, interrupt_cause};
        else           mcause_d = {1'b0, 59'b0, xcpt_cause_i};     
    end
end

//-----------------------------------------------
// mtval
//-----------------------------------------------
// ------------------------------------
// | Interrupt | Excption Code (WLRL) |
// ------------------------------------
// |    63     |62                   0|
// ------------------------------------
always @(posedge clk_i)
begin
    if (rst_i)
    begin
        mtval_r <= 64'b0;
    end
    else if (xcpt_valid_i && trap_to_M)
    begin
        if ((xcpt_cause_i >= 'd0  && xcpt_cause_i <= 'd1)  || 
            (xcpt_cause_i >= 'd4  && xcpt_cause_i <= 'd7)  || 
            (xcpt_cause_i >= 'd12 && xcpt_cause_i <= 'd13) || 
            (xcpt_cause_i == 'd15))
        begin
            mtval_r <= xcpt_tval_i;
        end
    end
    else if (csr_we_i && csr_waddr_i == `CSR_MTVAL)
    begin
        mtval_r <= csr_wdata_i;
    end
end

//-----------------------------------------------
// medeleg
//------------------------------------------------

always @(posedge clk_i)
begin
    if (rst_i)
    begin
        medeleg_r <= 64'b0;
    end
    else if (csr_we_i && csr_waddr_i == `CSR_MEDELEG)
    begin
        medeleg_r <= csr_wdata_i;
    end
end

//-----------------------------------------------
// mideleg
//------------------------------------------------
always @(posedge clk_i)
begin
    if (rst_i)
    begin
        mideleg_r <= 64'b0;
    end
    else if (csr_we_i && csr_waddr_i == `CSR_MEDELEG)
    begin
        mideleg_r <= csr_wdata_i;
    end
end

//-----------------------------------------------
// mcycle, mcycleh
//-----------------------------------------------
always @(posedge clk_i)
begin
    if (rst_i)
    begin
        mcycle_r    <= 64'b0;
    end
    else if (csr_we_i && csr_waddr_i == `CSR_MCYCLE)
    begin
        mcycle_r <= csr_wdata_i;
    end
    else
    begin
        mcycle_r <= mcycle_r + 1;
    end
end


// TODO: minstret, minstreth

// =============================================================================================
//  S-MODE SYSTEM Operations
//

//-----------------------------------------------
// sstatus
//-----------------------------------------------
// -------------------
// | SD | WPRI | UXL |
// -------------------
// | 63 |62  34|33 32|
// -------------------
// -----------------------------------------------------------------------------------------------------
// |  WPRI  | MXR | SUM | WPRI |  XS  |  FS  | WPRI | SPP | WPRI | SPIE | UPIE | WPRI | SIE | UIE |
// ------------------------------------------------------------------------------------------------
// |30    20| 19  | 18  |  17  |16  15|14  13|12   9|  8  |7    6|  5   |  4   |3    2|  1  |  0  |
// -----------------------------------------------------------------------------------------------------
assign sstatus = {mstatus_r[63], 29'b0, mstatus_r[33:32], 11'b0,
    mstatus_r[19:18], 1'b0, mstatus_r[16:13], 4'b0, mstatus_r[8],
    2'b0, mstatus_r[ 5: 4], 2'b0, mstatus_r[ 1: 0]};

//-----------------------------------------------
// sip
//-----------------------------------------------
// ----------------------------------------------------------------
// | WPRI | SEIP | UEIP | WPRI | STIP | UTIP | WPRI | SSIP | USIP |
// ----------------------------------------------------------------
// |63  12|  9   |  8   | 7  6 |  5   |  4   | 3  2 |  1   |  0   |
// ----------------------------------------------------------------
assign sip = {52'b0, mip_r[9:8], 2'b0, mip_r[5:4], 2'b0, mip_r[1:0]};

//-----------------------------------------------
// sie
//-----------------------------------------------
// ----------------------------------------------------------------
// | WPRI | SEIE | UEIE | WPRI | STIE | UTIE | WPRI | SSIE | USIE |
// ----------------------------------------------------------------
// |63  10|  9   |  8   | 7  6 |  5   |  4   | 3  2 |  1   |  0   |
// ----------------------------------------------------------------
assign sie = {52'b0, mie_r[9:8], 2'b0, mie_r[5:4], 2'b0, mie_r[1:0]};

//-----------------------------------------------
// satp
//-----------------------------------------------
// ---------------------------------
// | MODE | ASID(WARL) | PPN(WARL) |
// ---------------------------------
// |63  60|59        44|43        0|
// ---------------------------------
always @(posedge clk_i)
begin
    if (rst_i)
    begin
        satp_r <= 64'b0;
    end
    else if (csr_we_i && csr_waddr_i == `CSR_SATP)
    begin
        satp_r <= csr_wdata_i;
    end
end

//-----------------------------------------------
// stvec
//-----------------------------------------------
// ---------------
// | BASE | MODE |
// ---------------
// |63   2|1    0|
// ---------------
assign stvec_base = {stvec_r[XLEN-1 : 2], 2'b00};
always @(posedge clk_i)
begin
    if (rst_i)
    begin
        stvec_r <= 64'h0; // the entry point of timer ISR
    end
    else if (csr_we_i && csr_waddr_i == `CSR_STVEC)
    begin
        stvec_r <= csr_wdata_i;
    end
end

//-----------------------------------------------
// sscratch
//-----------------------------------------------
always @(posedge clk_i)
begin
    if (rst_i)
    begin
        sscratch_r <= 64'b0;
    end
    else if (csr_we_i && csr_waddr_i == `CSR_SSCRATCH)
    begin
        sscratch_r <= csr_wdata_i;
    end
end

//-----------------------------------------------
// sepc
//-----------------------------------------------
always @(posedge clk_i)
begin
    if (rst_i)
    begin
        sepc_r <= 64'b0;
    end
    else if (irq_taken && !trap_to_M)
    begin
        sepc_r <= nxt_unwb_PC_i;
    end
    else if (csr_we_i && csr_waddr_i == `CSR_SEPC)
    begin
        sepc_r <= csr_wdata_i;
    end
end

//-----------------------------------------------
// scause
//-----------------------------------------------
// ------------------------------------
// | Interrupt | Excption Code (WLRL) |
// ------------------------------------
// |    63     |62                   0|
// ------------------------------------

always @(posedge clk_i)
begin
    if (rst_i)
    begin
        scause_r <= 64'b0;
    end
    else if (irq_taken)
    begin
        scause_r <= scause_d;
    end
    else if (csr_we_i && csr_waddr_i == `CSR_SCAUSE)
    begin
        scause_r <= csr_wdata_i;
    end
end

always @(*)
begin
    scause_d = scause_r;
    if (irq_taken && !trap_to_M)
    begin
        scause_d = {1'b0, 59'b0, xcpt_cause_i};
    end
end

//-----------------------------------------------
// stval
//-----------------------------------------------
always @(posedge clk_i)
begin
    if (rst_i)
    begin
        stval_r <= 64'b0;
    end
    else if (xcpt_valid_i && !trap_to_M)
    begin
        if ((xcpt_cause_i >= 'd0  && xcpt_cause_i <= 'd1)  ||
            (xcpt_cause_i >= 'd4  && xcpt_cause_i <= 'd7)  ||
            (xcpt_cause_i >= 'd12 && xcpt_cause_i <= 'd13) ||
            (xcpt_cause_i == 'd15))
        begin
            stval_r <= xcpt_tval_i;
        end
    end
    else if (csr_we_i && csr_waddr_i == `CSR_STVAL)
    begin
        stval_r <= csr_wdata_i;
    end
end

// =============================================================================================
//  U-MODE SYSTEM Operations
//
//-----------------------------------------------
// cycle
//-----------------------------------------------
always @(posedge clk_i)
begin
    if (rst_i)
    begin
        cycle_r <= 64'b0;
    end
    else if (csr_we_i && csr_waddr_i == `CSR_CYCLE)
    begin
        cycle_r <= csr_wdata_i;
    end
    else
    begin
        cycle_r <= cycle_r + 1;
    end
end

// =============================================================================================
//  Operations and Multiplexer
//

always @( * )
begin
    case (csr_raddr_i)
        `CSR_MSTATUS:
            csr_data = mstatus_r;
        `CSR_MIE:
            csr_data = mie_r;
        `CSR_MIP:
            csr_data = mip_r;
        `CSR_MTVEC:
            csr_data = mtvec_r;
        `CSR_MSCRATCH:
            csr_data = mscratch_r;
        `CSR_MEPC:
            csr_data = mepc_r;
        `CSR_MCAUSE:
            csr_data = mcause_r;
        `CSR_MTVAL:       
            csr_data = mtval_r;
        `CSR_MCYCLE:
            csr_data = mcycle_r;
        `CSR_MINSTRET:
            csr_data = minstret_r[XLEN-1 : 0];
        `CSR_MVENDORID:
            csr_data = mvendorid;
        `CSR_MARCHID:
            csr_data = marchid;
        `CSR_MIMPID:
            csr_data = mimpid;
        `CSR_MHARTID:
            csr_data = mhartid;
        `CSR_MEDELEG:
            csr_data = medeleg_r;
        `CSR_MIDELEG:
            csr_data = mideleg_r;


        `CSR_SSTATUS:
            csr_data = sstatus;
        `CSR_SIE:
            csr_data = sie;
        `CSR_SIP:
            csr_data = sip;
        `CSR_SATP:
            csr_data = satp_r;
        `CSR_STVEC:
            csr_data = stvec_r;
        `CSR_SSCRATCH:
            csr_data = sscratch_r;
        `CSR_SEPC:
            csr_data = sepc_r;
        `CSR_SCAUSE:
            csr_data = scause_r;
        `CSR_STVAL:
            csr_data = stval_r;

        `CSR_CYCLE:                       // `CSR_CYCLE: 
            csr_data = cycle_r;  //     csr_data = cycle_r[31 : 0];      

        default :
            csr_data = 0;
    endcase
end

// ------------------
// mstatus[3] == mstatus_MIE
// mstatus[2] == mstatus_SIE
// mstatus[1] == mstatus_UIE

// mie[11] == mie_MEIE mie[7] == mie_MTIE mie[3] == mie_MSIE
// mie[ 9] == mie_SEIE mie[5] == mie_STIE mie[1] == mie_SSIE
// mie[ 8] == mie_UEIE mie[4] == mie_UTIE mie[0] == mie_USIE

always@(*) begin
    irq_taken         = 0;
    interrupt_cause   = 0; 
    trap_to_M         = 1;

    if (!xcpt_valid_i)
    begin
        case(privilege_level_r)
            `M_MODE: if (mstatus_r[3])
                    begin
                        //ext > tmr > sft
                        if (ext_irq_i & mie_r[11])     
                        begin
                            irq_taken       = 1;
                            trap_to_M       = 1;
                            interrupt_cause = 'd11;
                        end
                        else if (tmr_irq_i & mie_r[7])
                        begin
                            irq_taken      = 1;
                            trap_to_M      = 1;
                            interrupt_cause = 'd7;
                        end
                        else if (sft_irq_i & mie_r[3])
                        begin
                            irq_taken       = 1;
                            trap_to_M       = 1;
                            interrupt_cause = 'd3;
                        end
                        else
                        begin
                            irq_taken = 0;
                            trap_to_M = 1;
                        end
                    end
            `S_MODE: irq_taken = 0;
            `U_MODE: irq_taken = 0;
            default: irq_taken = 0;
        endcase
    end
    else
    begin
        irq_taken = 1;
        trap_to_M = (privilege_level_r == `M_MODE)?1:~medeleg_r[xcpt_cause_i];
    end
end

// ------------------
// mtvec[1:0] == 0 : MODE 0, set PC to BASE
// mtvec[1:0] == 1 : MODE 1, set PC to BASE + 4*casue
// mtvec[1:0] >= 2 : Reserved

always@(*)
begin
    if (trap_to_M)  // mtvec
    begin
        if (mtvec_r[1: 0] == 2'b00 || !mcause_d[31])    // Direct
        begin
            pc_handler = mtvec_base;
        end
        else    // vector
        begin
            pc_handler = mtvec_base + (mcause_d[62: 0] << 2);
        end
    end
    else            // stvec
    begin
        if (stvec_r[1: 0] == 2'b00)
        begin
            pc_handler = stvec_base;
        end
        else
        begin
            pc_handler = stvec_base + (scause_d[62: 0] << 2);
        end
    end
end

always @(posedge clk_i)
begin
    if (rst_i)
    begin 
        privilege_level_r <= `M_MODE;//M-Mode
    end
    else
    begin
        if (is_mret)
        begin
            privilege_level_r <= mstatus_r[12:11]; //MPP
        end
        else if (is_sret)
        begin
            privilege_level_r <= {1'b0, mstatus_r[8]}; //SPP
        end
        else if (irq_taken)
        begin
            privilege_level_r <= (trap_to_M) ? `M_MODE : `S_MODE;
        end
    end
end

// =============================================================================================
//  Output signals interface
//
assign csr_data_o = csr_data;

assign sys_jump_o = sys_jump_i;
assign sys_jump_csr_data_o = is_mret ? mepc_r :
                             is_sret ? sepc_r :
                             64'b0;

assign irq_taken_o  = irq_taken;
assign pc_handler_o = pc_handler;

assign privilege_level_o       = privilege_level_r;

endmodule
