ihn-int/SeniorProject/Hardware/dram_version/src/core_rtl/bpu.v

`timescale 1ns / 1ps
// =============================================================================
//  Program : bpu.v
//  Author  : Jin-you Wu
//  Date    : Jan/19/2019
// -----------------------------------------------------------------------------
//  Description:
//  This is the Branch Prediction Unit (BPU) of the Aquila core (A RISC-V core).
// -----------------------------------------------------------------------------
//  Revision information:
//
//  Aug/15/2020, by Chun-Jen Tsai:
//    Using a single BPU to handle both JAL and Branch instructions. In the
//    original code, an additional Unconditional Branch Prediction Unit (UC-BPU)
//    was used to handle the JAL instructions.
//
// Aug/16/2023, by Chun-Jen Tsai:
//    Replace the fully associative BHT by a TAG-based direct-mapping BHT table.
//    The 2-bit Bimodal FSM is still used. The performance drops a little (0.03
//    DMIPS), but the resource usage drops significantly. Note that we do not
//    have to use TAGged memory for direct-mapping BHT. We simply use it to
//    demonstrate how TAG memory can be implemented.
// -----------------------------------------------------------------------------
//  License information:
//
//  This software is released under the BSD-3-Clause Licence,
//  see https://opensource.org/licenses/BSD-3-Clause for details.
//  In the following license statements, "software" refers to the
//  "source code" of the complete hardware/software system.
//
//  Copyright 2019,
//                    Embedded Intelligent Systems Lab (EISL)
//                    Deparment of Computer Science
//                    National Chiao Tung Uniersity
//                    Hsinchu, Taiwan.
//
//  All rights reserved.
//
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
//  3. Neither the name of the copyright holder nor the names of its contributors
//     may be used to endorse or promote products derived from this software
//     without specific prior written permission.
//
//  THIS SOFTWARE IS PROVIDED BY THE COPYRIGHT HOLDERS AND CONTRIBUTORS "AS IS"
//  AND ANY EXPRESS OR IMPLIED WARRANTIES, INCLUDING, BUT NOT LIMITED TO, THE
//  IMPLIED WARRANTIES OF MERCHANTABILITY AND FITNESS FOR A PARTICULAR PURPOSE
//  ARE DISCLAIMED. IN NO EVENT SHALL THE COPYRIGHT HOLDER OR CONTRIBUTORS BE
//  LIABLE FOR ANY DIRECT, INDIRECT, INCIDENTAL, SPECIAL, EXEMPLARY, OR
//  CONSEQUENTIAL DAMAGES (INCLUDING, BUT NOT LIMITED TO, PROCUREMENT OF
//  SUBSTITUTE GOODS OR SERVICES; LOSS OF USE, DATA, OR PROFITS; OR BUSINESS
//  INTERRUPTION) HOWEVER CAUSED AND ON ANY THEORY OF LIABILITY, WHETHER IN
//  CONTRACT, STRICT LIABILITY, OR TORT (INCLUDING NEGLIGENCE OR OTHERWISE)
//  ARISING IN ANY WAY OUT OF THE USE OF THIS SOFTWARE, EVEN IF ADVISED OF THE
//  POSSIBILITY OF SUCH DAMAGE.
// =============================================================================
`include "aquila_config.vh"

module bpu #(
    parameter ENTRY_NUM = 32,
    parameter XLEN = 64
)(
    // System signals
    input               clk_i,
    input               rst_i,
    input               stall_i,

    // from Program_Counter
    input  [XLEN-1 : 0] pc_i, // Addr of the next instuction to be fetch

    // from Decode
    input               is_jal_i,
    input               is_cond_branch_i,
    input  [XLEN-1 : 0] dec_pc_i, // Addr of the instr. just processed by decoder.

    //from Execute
    input               exe_is_branch_i,
    input               branch_taken_i,
    input               branch_misprediction_i,
    input  [XLEN-1 : 0] branch_target_addr_i,

    // to Program_Counter
    output              branch_hit_o,
    output              branch_decision_o,
    output [XLEN-1 : 0] branch_target_addr_o
);

// The number of bits of identifying an entry.
localparam NBITS = $clog2(ENTRY_NUM);

// wires and registers
wire [NBITS-1 : 0]      read_addr;
wire [NBITS-1 : 0]      write_addr;
wire [XLEN-1 : 0]       branch_inst_tag;
wire                    we;
reg                     BHT_hit_ff, BHT_hit;    // a shift register

// two-bit saturating counter
reg  [1 : 0]            branch_likelihood[ENTRY_NUM-1 : 0];

// "we" is enabled to add a new entry to the BHT when the
// decoded instruction hasn't recorded yet.
assign we = ~stall_i & (is_cond_branch_i | is_jal_i) & !BHT_hit;

// doing word alignment
assign read_addr = pc_i[NBITS+2 : 2];
assign write_addr = dec_pc_i[NBITS+2 : 2];

integer idx;

// saturating counter update
always @(posedge clk_i)
begin
    if (rst_i)
        for (idx = 0; idx < ENTRY_NUM; idx = idx + 1)
            branch_likelihood[idx] <= 2'b0;
    else if (stall_i)
        for (idx = 0; idx < ENTRY_NUM; idx = idx + 1)
            branch_likelihood[idx] <= branch_likelihood[idx];
    else    // update the counter array
    begin
        if (we) // recieving a new instruction address
            branch_likelihood[write_addr] <= {branch_taken_i, branch_taken_i};
        else if (exe_is_branch_i)
        begin
            case(branch_likelihood[write_addr])
                2'b00:  // stringly not taken
                    branch_likelihood[write_addr] <=
                        (branch_taken_i) ? 2'b01 : 2'b00;
                2'b01:  // weakly not taken
                    branch_likelihood[write_addr] <=
                        (branch_taken_i) ? 2'b11 : 2'b00;
                2'b10:  // weakly taken
                    branch_likelihood[write_addr] <=
                        (branch_taken_i) ? 2'b11 : 2'b00;
                2'b11:  // strongly taken
                    branch_likelihood[write_addr] <= 
                        (branch_taken_i) ? 2'b11 : 2'b10;
            endcase
        end
    end
end

// BHT. A direct-mapping cache table is used to store branch history.
// Each entry contains two fields: target address and the pc as a tag.
//
distri_ram #(
    .ENTRY_NUM(ENTRY_NUM),
    .XLEN(XLEN*2)
) BPU_BHT (
    .clk_i(clk_i),
    .we_i(we),

    .write_addr_i(write_addr),
    .read_addr_i(read_addr),

    .data_i( {branch_target_addr_i, dec_pc_i} ),
    .data_o( {branch_target_addr_o, branch_inst_tag} )
);

// Delay the BHT hit flag at the Fetch stage for two clock cycles.
always @(posedge clk_i)
begin
    if(rst_i) BHT_hit <= 2'b00;
    else if (!stall_i) begin
        BHT_hit_ff <= branch_hit_o;
        BHT_hit <= BHT_hit_ff;
    end
end

// output signals assignment
assign branch_hit_o = (branch_inst_tag == pc_i);
assign branch_decision_o = branch_likelihood[read_addr][1];

endmodule
